b-wave/Davis-ISS-Weather-Sensor-Project/legacy/README.md

## Test File
These files were compiled using the modified kabooki/deKay libraries.  They all were working although the library files use must be the the versions in place at the time.  New updated Teensy friendly libraries permit using the full lowpowerlabs linraries now that make these outdated. 
- Reciever test
- Transmitter test
-  IRQ test

Your milage may vary!
