b-wave/Davis-ISS-Weather-Sensor-Project/resources/davis_wind_direction_sensoe.jpg

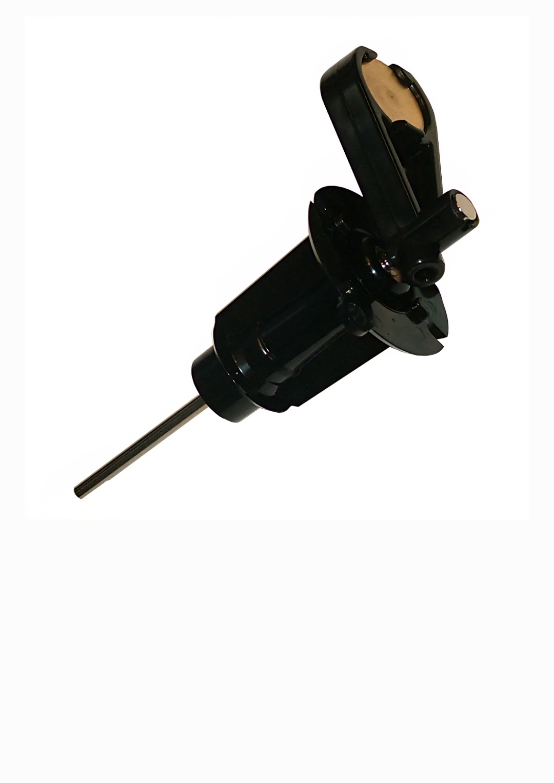
resources/davis_wind_direction_sensoe.jpg
