b-wave/Davis-ISS-Weather-Sensor-Project/ISS_Drivers/examples/AS3935_test/AS3935_test.ino.txt

/**
 * AS3935_test.ino — Standalone test sketch for AS3935 sensor driver
 *
 * ISS Packet Engine — Sensor Driver Tests
 *
 * Wiring (Teensy 4.x):
 *   AS3935 SDA → Pin 18 (SDA)
 *   AS3935 SCL → Pin 19 (SCL)
 *   AS3935 IRQ → Pin 7 (IRQ 07)
 *   AS3935 VCC → 3.3V
 *   AS3935 GND → GND
 *   AS3935 SDO → GND (address 0x76) or VCC (address 0x77)
 *
 * Output: Serial monitor at 115200 baud
 */

/*

  By: Elias Santistevan
  SparkFun Electronics
  Date: May, 2019
  License: This code is public domain but you buy me a beer if you use this and we meet someday (Beerware license).

*/

#include <SPI.h>
#include <Wire.h>
#include <SparkFun_AS3935.h>

#define INDOOR 0x12 
#define OUTDOOR 0xE
#define LIGHTNING_INT 0x08
#define DISTURBER_INT 0x04
#define NOISE_INT 0x01

SparkFun_AS3935 lightning;

// Interrupt pin for lightning detection 
const int lightningInt = 7; // Next 
int spiCS = 8; //SPI chip select pin

// This variable holds the number representing the lightning or non-lightning
// event issued by the lightning detector. 
int intVal = 0;
int noise = 2; // Value between 1-7 
int disturber = 2; // Value between 1-10

void setup()
{
  // When lightning is detected the interrupt pin goes HIGH.
  pinMode(lightningInt, INPUT); 

  Serial.begin(115200); 
  Serial.println("AS3935 Franklin Lightning Detector"); 

  SPI.begin(); 
  if( !lightning.beginSPI(spiCS) ){ 
    Serial.println ("Lightning Detector did not start up, freezing!"); 
    while(1); 
  }
  else
    Serial.println("Schmow-ZoW, Lightning Detector Ready!");

  // The lightning detector defaults to an indoor setting at 
  // the cost of less sensitivity, if you plan on using this outdoors 
  // uncomment the following line:
  //lightning.setIndoorOutdoor(OUTDOOR); 
}

void loop()
{
   // Hardware has alerted us to an event, now we read the interrupt register
  if(digitalRead(lightningInt) == HIGH){
    intVal = lightning.readInterruptReg();
    if(intVal == NOISE_INT){
      Serial.println("Noise."); 
      // Too much noise? Uncomment the code below, a higher number means better
      // noise rejection.
      //lightning.setNoiseLevel(noise); 
    }
    else if(intVal == DISTURBER_INT){
      Serial.println("Disturber."); 
      // Too many disturbers? Uncomment the code below, a higher number means better
      // disturber rejection.
      //lightning.watchdogThreshold(disturber);  
    }
    else if(intVal == LIGHTNING_INT){
      Serial.println("Lightning Strike Detected!"); 
      // Lightning! Now how far away is it? Distance estimation takes into
      // account any previously seen events in the last 15 seconds. 
      byte distance = lightning.distanceToStorm(); 
      Serial.print("Approximately: "); 
      Serial.print(distance); 
      Serial.println("km away!"); 
    }
  }
  delay(100); // Slow it down.
}
