b-wave/Davis-ISS-Weather-Sensor-Project/Davis-ISS-Transmitter/ISSTx/DavisHopTable.h

#pragma once
#include <stdint.h>

// Davis ISS hop table (US 915 MHz band)
// 51 channels, 200 kHz spacing
static const uint32_t davisHopTable[] = {
    902300000, 902500000, 902700000, 902900000, 903100000, 903300000,
    903500000, 903700000, 903900000, 904100000, 904300000, 904500000,
    904700000, 904900000, 905100000, 905300000, 905500000, 905700000,
    905900000, 906100000, 906300000, 906500000, 906700000, 906900000,
    907100000, 907300000, 907500000, 907700000, 907900000, 908100000,
    908300000, 908500000, 908700000, 908900000, 909100000, 909300000,
    909500000, 909700000, 909900000, 910100000, 910300000, 910500000,
    910700000, 910900000, 911100000, 911300000, 911500000, 911700000,
    911900000, 912100000, 912300000
};

static const uint8_t DAVIS_HOP_COUNT = sizeof(davisHopTable) / sizeof(davisHopTable[0]);
