b-wave/Davis-ISS-Weather-Sensor-Project/ISS_Drivers/examples/AS3935_test/AS3935_test.ino

/**
 * AS3935_test.ino — Standalone test sketch for AS3935 sensor driver
 *
 * ISS Packet Engine — Sensor Driver Tests
 *
 * Wiring (Teensy 4.x):
 *   AS3935 SDA → Pin 18 (SDA)
 *   AS3935 SCL → Pin 19 (SCL)
 *   AS3935 IRQ → Pin 7  (IRQ 07)
 *   AS3935 VCC → 3.3V
 *   AS3935 GND → GND
 *   AS3935 SDO → open (address 0x03)
 * Input: Interrupt signal (high) from AS3935 to indicate activity 
 * Output: Serial monitor at 115200 baud
 */


/*
  This example code will walk you through the rest of the functions not
  mentioned in the other example code. This includes different ways to reduce
  false events, how to power down (and what that entails) and wake up your
  board, as well as how to reset all the settings to their factory defaults. 

  By: Elias Santistevan
  SparkFun Electronics
  Date: July, 2019
  License: This code is public domain but you buy me a beer if you use this and we meet someday (Beerware license).
*/

#include <SPI.h>
#include <Wire.h>
#include <SparkFun_AS3935.h>

// 0x03 is default, but the address can also be 0x02, or 0x01.
// Adjust the address jumpers on the underside of the product. 
#define AS3935_ADDR 0x03 
#define INDOOR 0x12 
#define OUTDOOR 0xE
#define LIGHTNING_INT 0x08
#define DISTURBER_INT 0x04
#define NOISE_INT 0x01


// If you're using I-squared-C then keep the following line. Address is set to
// default. 
SparkFun_AS3935 lightning(AS3935_ADDR);

// Interrupt pin for lightning detection 
const int lightningInt = 7; 

// Values for modifying the IC's settings. All of these values are set to their
// default values. 
byte noiseFloor = 2;
byte watchDogVal = 2;
byte spike = 2;
byte lightningThresh = 1; 

// This variable holds the number representing the lightning or non-lightning
// event issued by the lightning detector. 
byte intVal = 0; 

void setup()
{
  // When lightning is detected the interrupt pin goes HIGH.
  pinMode(lightningInt, INPUT); 

    Serial.begin(115200);
    while (!Serial && millis() < 5000);  // Wait for USB serial (max 5s)

    Serial.println();
    Serial.println("========================================");
    Serial.println("  AS3935 Lightning Sensor Driver Test");
    Serial.println("========================================");
    Serial.println();

  Wire.begin(); // Begin Wire before lightning sensor. 
      // --- Initialization ---
    Serial.print("Initializing AS3935 at 0x");
    Serial.print(AS3935_ADDR, HEX);
    Serial.print("... ");

  if( !lightning.begin() ){ // Initialize the sensor. 
    Serial.println (" Failed!"); 
    while(1); 
  }
  else
    Serial.println(" Ready!\n");
  // "Disturbers" are events that are false lightning events. If you find
  // yourself seeing a lot of disturbers you can have the chip not report those
  // events on the interrupt lines. 
  lightning.maskDisturber(true); 
  int maskVal = lightning.readMaskDisturber();
  Serial.print("Are disturbers being masked: "); 
  if (maskVal == 1)
    Serial.println("YES"); 
  else if (maskVal == 0)
    Serial.println("NO"); 

  // The lightning detector defaults to an indoor setting (less
  // gain/sensitivity), if you plan on using this outdoors 
  // uncomment the following line:
  //lightning.setIndoorOutdoor(OUTDOOR); 
  int enviVal = lightning.readIndoorOutdoor();
  Serial.print("Are we set for indoor or outdoor: ");  
  if( enviVal == INDOOR )
    Serial.println("Indoor.");  
  else if( enviVal == OUTDOOR )
    Serial.println("Outdoor.");  
  else 
    Serial.println(enviVal, BIN); 
 
  // Noise floor setting from 1-7, one being the lowest. Default setting is
  // two. If you need to check the setting, the corresponding function for
  // reading the function follows.    

  lightning.setNoiseLevel(noiseFloor);  

  int noiseVal = lightning.readNoiseLevel();
  Serial.print("Noise Level is set at: ");
  Serial.println(noiseVal);

  // Watchdog threshold setting can be from 1-10, one being the lowest. Default setting is
  // two. If you need to check the setting, the corresponding function for
  // reading the function follows.    

  lightning.watchdogThreshold(watchDogVal); 

  int watchVal = lightning.readWatchdogThreshold();
  Serial.print("Watchdog Threshold is set to: ");
  Serial.println(watchVal);

  // Spike Rejection setting from 1-11, one being the lowest. Default setting is
  // two. If you need to check the setting, the corresponding function for
  // reading the function follows.    
  // The shape of the spike is analyzed during the chip's
  // validation routine. You can round this spike at the cost of sensitivity to
  // distant events. 

  lightning.spikeRejection(spike); 

  int spikeVal = lightning.readSpikeRejection();
  Serial.print("Spike Rejection is set to: ");
  Serial.println(spikeVal);

  // This setting will change when the lightning detector issues an interrupt.
  // For example you will only get an interrupt after five lightning strikes
  // instead of one. Default is one, and it takes settings of 1, 5, 9 and 16.   
  // Followed by its corresponding read function. Default is zero. 

  lightning.lightningThreshold(lightningThresh); 

  uint8_t lightVal = lightning.readLightningThreshold();
  Serial.print("The number of strikes before interrupt is triggerd: "); 
  Serial.println(lightVal); 

  // When the distance to the storm is estimated, it takes into account other
  // lightning that was sensed in the past 15 minutes. If you want to reset
  // time, then you can call this function. 

  //lightning.clearStatistics(); 

  // The power down function has a BIG "gotcha". When you wake up the board
  // after power down, the internal oscillators will be recalibrated. They are
  // recalibrated according to the resonance frequency of the antenna - which
  // should be around 500kHz. It's highly recommended that you calibrate your
  // antenna before using these two functions, or you run the risk of schewing
  // the timing of the chip. 

  //lightning.powerDown(); 
  //delay(1000);
  //if( lightning.wakeUp() ) 
   // Serial.println("Successfully woken up!");  
  //else 
    //Serial.println("Error recalibrating internal osciallator on wake up."); 
  
  // Set too many features? Reset them all with the following function.
  // lightning.resetSettings();
  
}

void loop()
{
  if(digitalRead(lightningInt) == HIGH){
    // Hardware has alerted us to an event, now we read the interrupt register
    // to see exactly what it is. 
    intVal = lightning.readInterruptReg();
    if(intVal == NOISE_INT){
      Serial.println("Noise."); 
    }
    else if(intVal == DISTURBER_INT){
      Serial.println("Disturber."); 
    }
    else if(intVal == LIGHTNING_INT){
      Serial.println("Lightning Strike Detected!"); 
      // Lightning! Now how far away is it? Distance estimation takes into
      // account previously seen events. 
      byte distance = lightning.distanceToStorm(); 
      Serial.print("Approximately: "); 
      Serial.print(distance * 0.621371); 
      Serial.println("mi away!"); 

      // "Lightning Energy" and I do place into quotes intentionally, is a pure
      // number that does not have any physical meaning. 
      long lightEnergy = lightning.lightningEnergy(); 
      Serial.print("Lightning Energy: "); 
      Serial.println(lightEnergy); 

    }
  }
}
