b-wave/Davis-ISS-Weather-Sensor-Project/(commit log)

2026-03-15 Revise README for project overview and details
    Expanded the README to provide detailed project overview, architecture, goals, power system, RF stack, mechanical notes, and development plan.
2026-03-16 Update README with sensor images and descriptions
    Added images for wind direction and wind speed sensors in the README.
2026-03-18 Add files via upload
    Teensy RFM69 compatible libraries
2026-03-18 Add files via upload
    Transmit test skeleton - compiles with RFM69 Teensy Library
2026-03-26 Changed Teensy IRQ / pins mappings - Clean-up
    Updated IRQ pin definitions to match Teensy 3.x hardware
    - Prepped the sketch for DIO0‑based interrupt handling
    - No functional changes to packet decode yet
    - Verified wiring and Teensy interrupt capability
    - This commit sets the stage for full interrupt‑driven RX in the next phase
2026-03-26 Add RFM69 IRQ test sketch (Teensy) with notes on noise-trigger behavior
    This is a standalone IRQ test for validating DIO0 → Teensy interrupt chain It includes:
    - temporary register defines missing from the Davis fork
    - Confirms FIFO drain + RX restart logic
    - Observed real ISS timing patterns (40–70s gaps, double IRQs at hop boundaries)
    NOTE: Sketch will also trigger on RF noise or partial packets — expected behavior
    Useful as a bench diagnostic tool before integrating full RX logic, and if you don't have an active ISS signal to test with.
    [RFM69_IRQ_Test.ino]
2026-04-09 Add files via upload
    new library files for Teensy w/
2026-04-11 Add files via upload
    Compiles! w/ Debugged: SPI, IRQ, and RESET
2026-04-22 Add files via upload
    Brought the RFM69 back from the dead.
    FSK chain fully alive, hop table validated, ISS packets flowing. On to hop‑sync + decode.
2026-04-23 Add files via upload
    This is a known‑good baseline. A register dump proves the RF front‑end is now byte‑for‑byte correct:
    Bitrate correct
    Deviation correct
    RXBW/AFCBW correct
    Sync correct
    Packet engine correct
    FRF correct
    OPMODE correct
2026-04-25 Add files via upload
    Davis ISS Packet Sniffer — REV: 042526 — VERS: 1.0
    First Stable Release (Phase A Complete)
    Summary
    Initial working release of the Teensy‑based Davis ISS Packet Sniffer.
    Successfully locks onto ISS hop sequence, validates packets, and prints clean CRC‑verified frames.
2026-04-26 Update developer notes with Arduino and GitHub tips
    Added notes on Arduino sketch folder requirements, GitHub visibility tricks for .ino files, and metadata corruption issues when pasting code from Arduino IDE.
2026-04-26 Add DavisRFM69 driver implementation
    This file implements the DavisRFM69 driver for the RFM69W/RFM69HW and SX1231/1231H transceivers, enabling communication with Davis Instruments' wireless Integrated Sensor Suite (ISS). It includes configuration, packet handling, and various functions for managing the transceiver's operation.
2026-04-27 Add files via upload
    Compiles - not working!
    [Davis_ISS_PacketSniffer_V1.ino]
2026-04-27 Add files via upload
    LED indicators added!
2026-04-30 Add files via upload
    // REV: 042726
    // VERS: 1.1
    //
    // Notes:
    // - Funcional
    // - Added non-blocking Status LEDs
    // - Working serial command processor
    // - TODO: add packet stats and Channel Filter
2026-05-04 Add files via upload
    V1.2.2 (050326) — Radio-lockup fix, noise guard, station filter
    // • FIX: radio.setChannel() now ALWAYS called after receiveDone()
    // to prevent radio staying in STANDBY mode (caused 15+ min lockups)
    // • FIX: Noise guard — CRC FAIL packets ignored during park mode
    // (hopCount==0). Only CRC OK can break out of park-and-wait.
    // During tracking (hopCount>0), CRC FAIL still follows ISS.
    // • FIX: Station ID filter — rejects packets from wrong station during
    // park mode so multi-ISS environments don't cross-lock.
    // • FIX: Resync (hopCount>12) now returns immediately after parking
    // to prevent un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
    [Davis_ISS_PacketSniffer_V1.ino]
2026-05-06 Add files via upload
    Updated test files to match current hardware. Added AS5048A (SPI version) and AS3935_test (i2c version) All tests run on current hardware. Missing Rain_test.
    [AS3935_test.ino, AS5048A_test.ino, AS5048B_test.ino, AnalogChannels_test.ino]
2026-05-06 Add files via upload
    These tests are to help generate and verify correct Davis ISS packets.
    [ISS_PacketEngine.ino, iss_bridge.py, iss_packet_decoder.py]
2026-05-07 Revise ISS Packet Engine Test Program documentation
    Updated wiring diagrams and data flow descriptions in the test program documentation.
2026-05-07 Delete Davis_ISS_PacketSniffer_V1/DavisRFM69.cpp
    now using custom library - no longer need duplicate includes
    [DavisRFM69.cpp]
2026-05-07 Add files via upload
    Current sketch folder - compiles / runs fine.
2026-05-08 Add files via upload
    Hardware tested! Need to add drivers for: AS5048ADriver (SPI) and AS3935 (I2C). the example files AS3935_test.ino and AS5048A_test.ino now only use chip libraries.
2026-05-08 Add files via upload
    Updated pins from prototype. Need to change the lightning - based on the live OTA test the current packet is used quite frequently by the ISS transmitter. Need to change the ISS_Drivers to pick up the current hardware.
2026-05-15 Add files via upload
    Revision: 0.1. Version: 051526
    First complete version. Compiles, Not tested.
    Notes:
    1) Uses local files not custom libraries. The custom include. Place all the included files should be in the sketch folder.
    2) Uses Teensy 3.2 Not optimized for Teensy 4.x but is compatible with both.
    3) See hardware section for modules and datasheets.
2026-05-16 Clarify test jig assembly and fix typos
    Updated README to clarify assembly details and correct typos.
